ravestrapon/ravestrapon/www/images/left.jpg

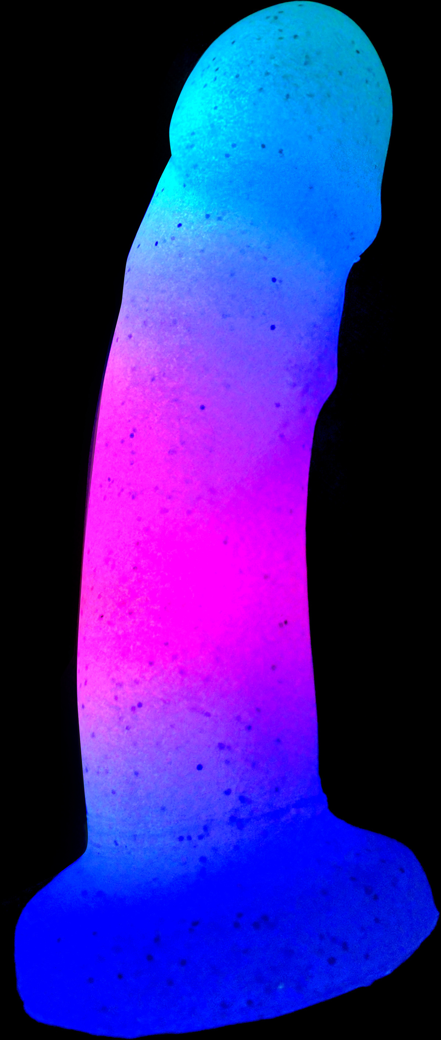
www/images/left.jpg
