ravestrapon/ravestrapon/www/images/right.jpg

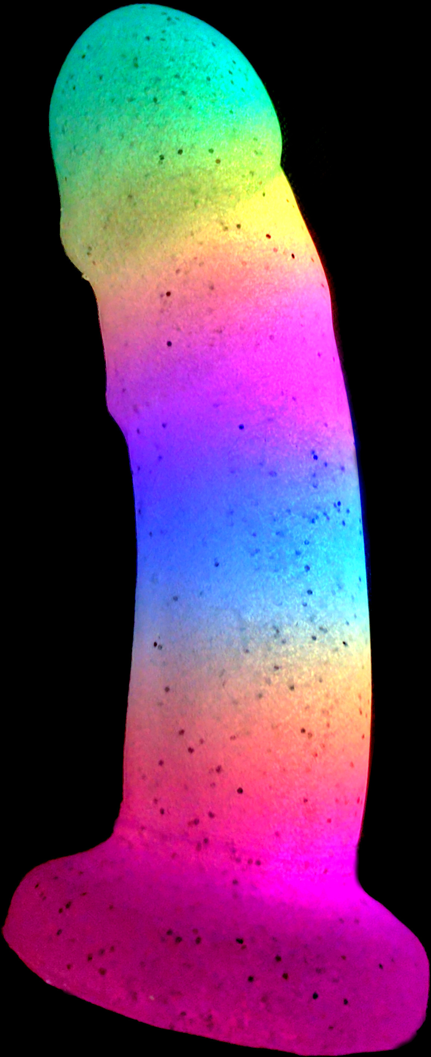
www/images/right.jpg
