ravestrapon/ravestrapon/README.md

# ravestrapon
Source repository for ravestrapon source material and board design
