ravestrapon/ravestrapon/eagle/projects/LiPo Charger/max1551_charger_v1.brd

## EAGLE design eagle/projects/LiPo Charger/max1551_charger_v1.brd (2017-11-30)

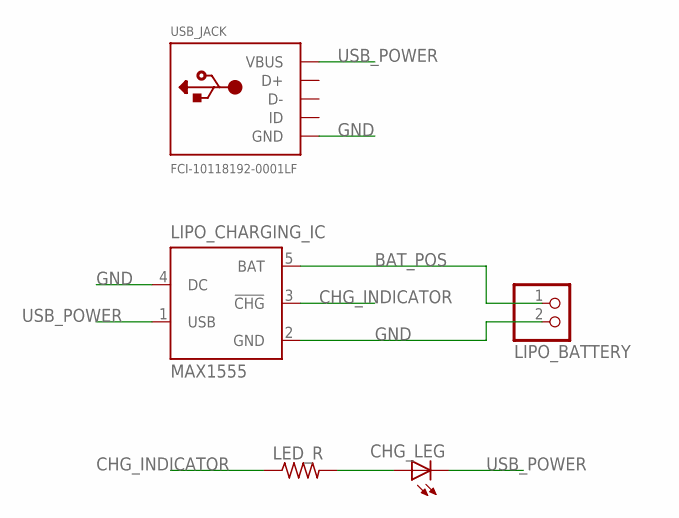
[picture p3: schematic max1551_charger_v1.sch]

Parts:
CHG_LEG: LED3MM
LED_R: R-US_0207/2V; 0207/2V
LIPO_BATTERY: JST_2PIN-SMT-RA; JST-PH-2-SMT-RA
LIPO_CHARGING_IC: MAX1555; SOT23-5L
USB_JACK: FCI-10118192-0001LF

Connections:
BAT_POS: LIPO_BATTERY.1 (2), LIPO_CHARGING_IC.5 (BAT)
CHG_INDICATOR: LED_R.1, LIPO_CHARGING_IC.3 (!CHG)
GND: LIPO_BATTERY.2 (1), LIPO_CHARGING_IC.2 (GND), LIPO_CHARGING_IC.4 (DC), USB_JACK.GND
unnamed: CHG_LEG.A, LED_R.2
USB_POWER: CHG_LEG.K (C), LIPO_CHARGING_IC.1 (USB), USB_JACK.VCC (VBUS)

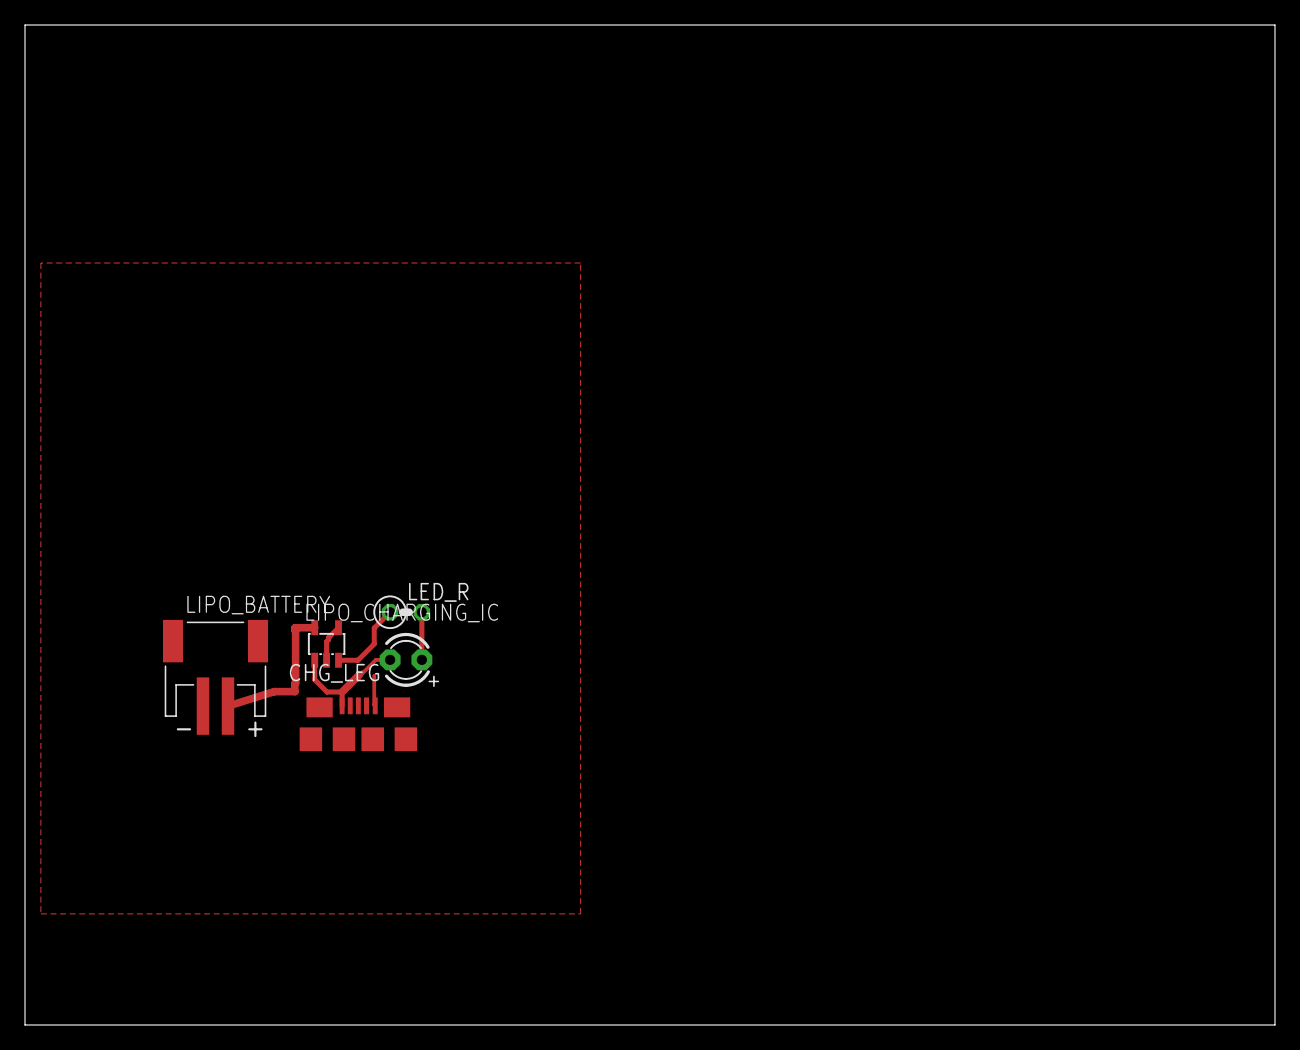
[picture p4: board max1551_charger_v1.brd from above]

Board: 2 copper layers, 100.0 x 80.0 mm, 5 parts (0 on the bottom side), 5 nets.
