ravestrapon/ravestrapon/(commit log)

2017-11-27 Lipo Charging Test Board
    This includes the EagleCAD source for a LiPo Charging test board.
    [max1555_charger_v1.brd, max1555_charger_v1.sch]
2017-11-27 Fixing the LiPo Part # from 1555 to 1551
    [max1555_charger_v1.brd, max1555_charger_v1.sch]
2017-11-27 Adding the lost files, oops
    [max1551_charger_v1.brd, max1551_charger_v1.sch]
2017-11-27 Move eagle projects to better match Eagle structure
    This moves the Eagle projects into their own folder called
    projects/ that can be added to the "directories" strings in Eagle
    more easily (instead of having to set up symlinks/etc)
    [max1551_charger_v1.brd, max1551_charger_v1.sch]
2017-11-30 Update LiPo Charger with MAX 1551
    This board was printed and tested and it seems to work.
    It's a bit simple/slow though so a better charger circuit
    would probably be advantageous in the future. Plus the
    MAX1551 charger ICs are expensive ~$2 each.
    However, it works! So I'm saving these designs for later
    [max1551_charger_v1.brd, max1551_charger_v1.sch]
2017-12-28 Adding battery monitor sketch
    This is a simple sketch I'm using to monitor the
    voltage of a test battery over time. Essentially this
    sketch just reads off ADC0 at regular intervals and
    converts that into a voltage reading. That value
    is then printed onto the serial port, which can
    be logged by a host computer to get a graph of voltage
    over time. Use the collect_logs.sh script to add
    timestamps and save them to the host computer's hdd.
2017-12-28 Adding support for a second voltage to monitor
    This adds in support for a voltage to monitor on
    A1 as well, this input is assumed to have a 1/2 voltage
    divider attached to it (to allow it to measure larger
    voltages)
2017-12-28 Use internal ADC reference for battery monitor
    Using the internal 2.56V reference voltage instead
    of Vcc for measuring the battery voltages. This makes it
    much more accurate, but requires the use of external
    voltage dividers to bring the signals into range, so the
    SW has to compensate. This patch also includes precisely
    computed scalers for each of the probes on my battery
    monitor -- obviously those numbers have to change with
    different resistor values.
2017-12-28 Speed up sampling and change pin #
2017-12-28 Add Script to plot battery monitor output
    This uses matplotlib to make a more human-readable
    chart of the power testing graphs
2017-12-28 Add an auto-updating server for showing battery monitor plots
2017-12-28 Add ATMega16 testing code
    This is a simple Hello World program to blink an
    LED and set up the fuses on an ATMega16. This proves
    that the programmer and the circuit board are all working :D
2017-12-28 Adding in the first draft of the actual src
    This is heavily copied from another project of mine
    but most importantly includes a build.sh that can compile
    and flash using my ATmega16 board. This is tricky because
    FastLED needs Arduino, and I'm not using Arduino to update
    nor is there an ATmega16 Arduino. So this requires:
    MightyCore installed in your Arduino install. This adds ATmega16
    support for Arduino. It's pretty easy to install.
    A slightly hacked version of FastLED -- I just used the existing
    fastpin.h file but modified the line that referenced the ATmega16U2
    and made it ATmega16 instead. (Also remove the HOODBOOT condition)
    I was surprised to see it work, but sure enough, it see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
2017-12-28 Add connection test to build script
    This adds a simple connection test to the build script so it
    can give more informative errors. Without this, when you don't
    have the programmer or mcu plugged in, the error messages are
    about fuses which can be confusing. This way it fails earlier
    and it's clear you just need to check your connections and the
    error has nothing to do with setting fuses.
    [ravestrapon.ino]
2017-12-29 Remove erroneous 1s pause
    For some reason there was a 1s pause after each pass
    through the animations. This caused a weird glitch
    each time it restarted at the top of the list again.
    This patch just removes this delay. It looks much smoother
    without it and I think it was just a forgotten leftover
    piece of a test or something.
    [ravestrapon.ino]
2018-01-02 Add support for buttons & Fuel gauge
    This is rudamentary support for a "fuel gauge" on ADC4, which
    is meant to be wired to a 1/2 voltage divider connected to the
    battery voltage.
    The two buttons are wired to external interrupts 0 & 1 so they
    can be interrupt-driven buttons, which is also new. The code is
    somewhat janky for this and can't interrupt the animations yet
    (which kinda defeats the whole point) but I'm working for fix that
    currently.
    Right now when you press the brightness button the brightnesses update
    on the fly, but the fuel gauge won't display until the current
    animation is done. I'll have to refactor the animation code to
    achieve that.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
    [ravestrapon.ino]
2018-01-18 Refactor for interruptable animations
    Previously there was no good was to interrupt an animation due
    to the way they were implimented. This new OOP method should
    fascilitate a more regular frame rate and allow you to interrupt
    them which is required for a fuel gauge to work right.
    Only a couple animations are refactored now. More to follow
2018-01-18 Porting Tracer animation over to the new style
2018-01-18 Fixing a few minor bugs in the Drop animation
    [drop.h]
2018-01-18 Fix memory leak -- delete old Animation objects
    This was a silly mistake, we should definitely be deleting old
    Animation objects once we're done with them!
    [ravestrapon.ino]
2018-01-19 Adding a frame count to animations
    This allows the animation to be totally selfcontained -- now
    the nextFrame() function returns a bool (indicating if it's
    generated as many frames as expect already) and the main loop
    can just move on when it says false. This means we can just push
    a whole new animation into place and it'll restart right back
    where it expected. This will allow interrupting animations (like
    for the battery indicator) much much more smoothly
2018-01-19 Add an interrupting Fuel Guage
    The fuel guage now "works" although the animation is lame right now.
    When you press the button a Fuel Guage animation is pushed into place
    over whatever the current animation is and then run out before it
    returns to that same animation seamlessly. No more waiting for an
    animation to complete before the battery status is revealed! Next, I
    need to make it look better, check if power is plugged in, and possibly
    stay on as long as you hold down the battery button.
2018-01-19 Keep the fuel guage on as long as the btn is down
    This is a slick user interface upgrade. As long as the user
    holds down the button the battery level will keep being displayed.
    If you don't hold it down though, it'll just play for a little bit
    and then stop, do you don't *have* to hold it down if you don't
    want to. Also this adds a pulsing animation to the fuel guage that
    greatly upgrades it's appearance
2018-01-19 Formalize how interrupting animations work
    This makes it clear that there is only 1 "standby" animation and
    it is a slot reserved for the "normal" animation that was first
    interrupted. Repeated interruptions will erase the existing interrupting
    animation from memory. This prevents the stack from building up
    and give a more responsive feel.
    [ravestrapon.ino]
2018-01-20 Fixing the interrupt #s in comments
    [ravestrapon.ino]
2018-01-20 Moving the brightness change work out of the ISR
    In an effort to standardize my system and remove as much work as
    possible from the ISR, this patch changes the actual work for
    changing brightnessed into the main loop. Similar to how other
    interruptions should/are handled.
2018-01-20 Add in USB power detection to the fuel gauge.
    This CL adds in the logic to the fuel gauge to make sure that the USB
    power cable isn't plugged in when it's doing it's readings. If it is,
    then it plays the "currently charging" animation instead of the "fuel
    gauge" one, to let the user know that it's plugged in. The animation
    isn't the greatest right now, but the plumbing is all in place.
    Still to do:
    Make it play an animation automatically when you plug/unplug
    the usb power to let you know it's working.
    Better animation for charging
    Hook up the status LEDs from the LiPo charger to GPIOs to get
    better/accurate charging status information.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
2018-01-20 Better "currently charging" animation
2018-01-23 Make the system more robust to errors
    This is accomplished by enabling a watchdog timer. The WDT reboots
    the microcontroller if it doesn't get reset for 60ms. This shouldn't
    happen unless something is awry though -- because the WDT gets reset
    right before attempting to generate a new frame. There should definitely
    be a new frame generated at least once every 60ms, so if that isn't
    happening it makes sense to reboot the whole microcontroller.
    To try and make this rebooting more "seamless" I also added some code
    to store the brightness settings to EEPROM and resore them on boot.
    This way, if you had the brightness down very low and the system gets
    rebooted by the WDT, you won't suddenly ha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
    [ravestrapon.ino, savedsettings.h]
